GaryDyr/VL53L0X-LIDAR-ToF-Experiments/media/image9.png

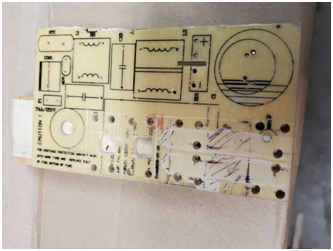
media/image9.png
