GaryDyr/VL53L0X-LIDAR-ToF-Experiments/vl53l0x_chip1.png

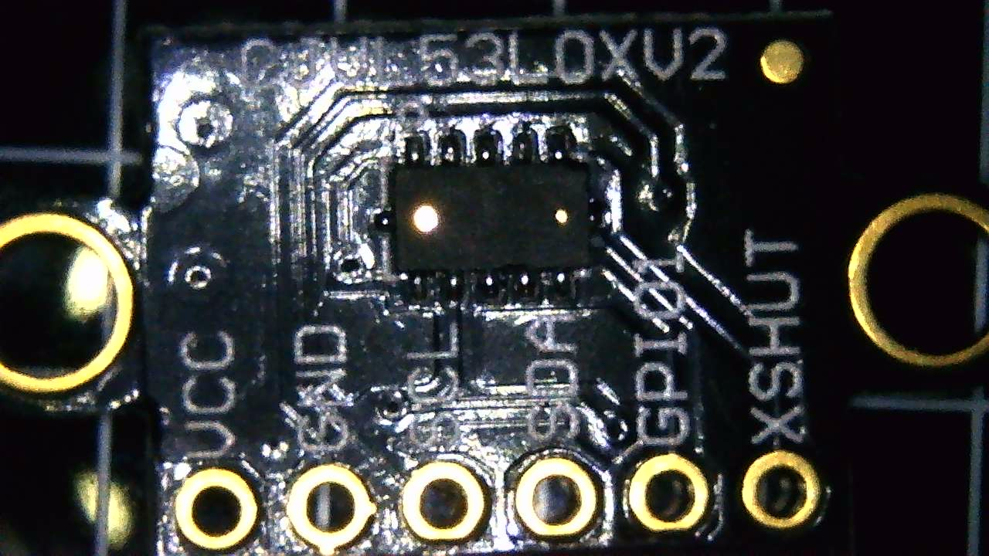
vl53l0x_chip1.png
